furrtek/VirtualTap/JTAG_pinout.png

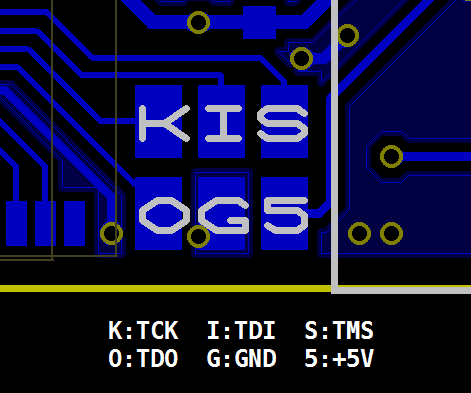
JTAG_pinout.png
