furrtek/VirtualTap/pcb/vt_c_schematic.png

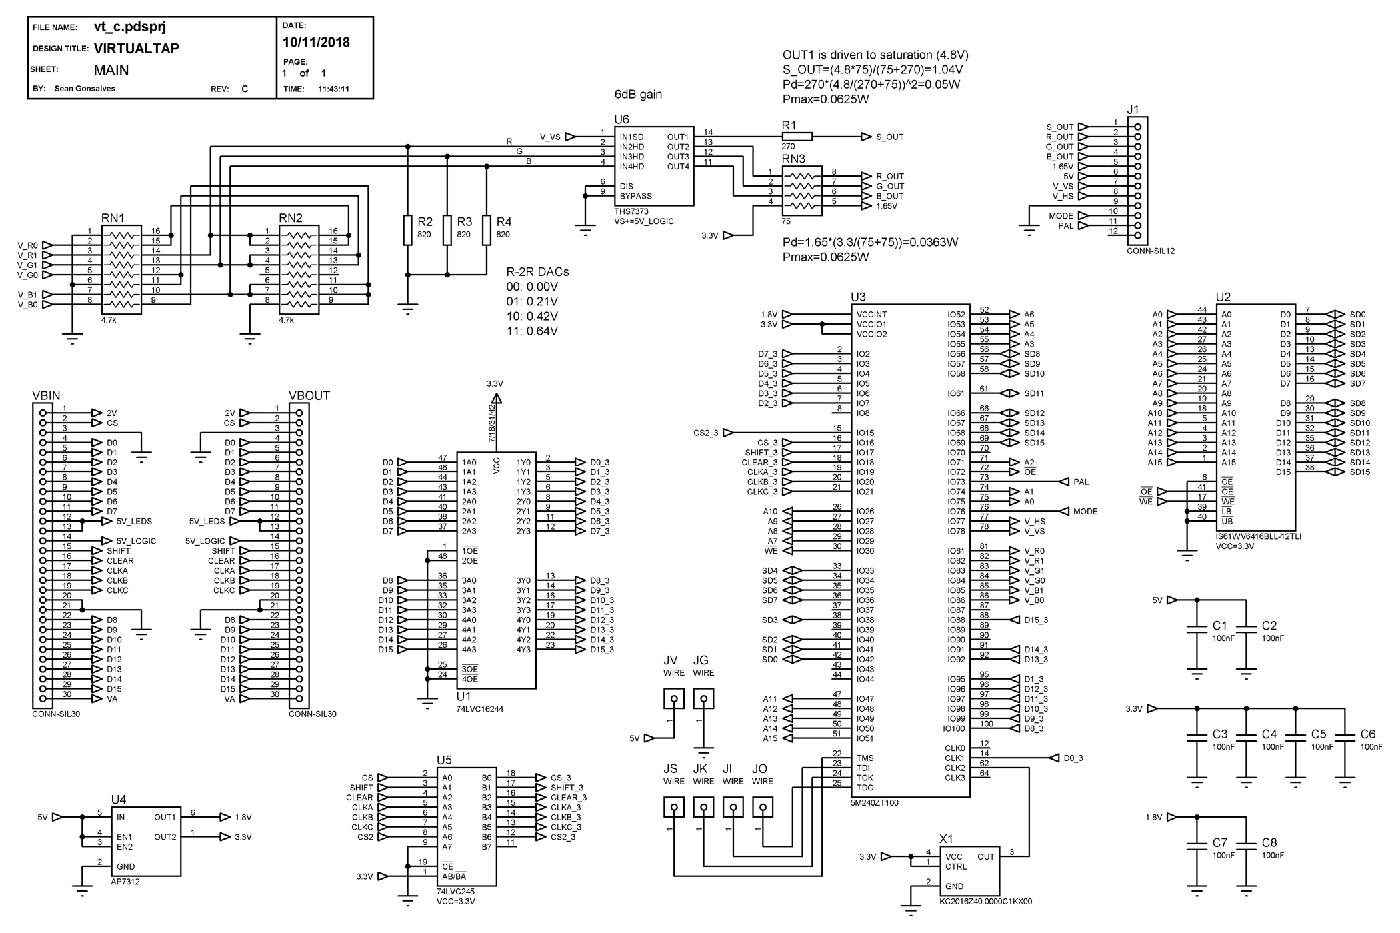
pcb/vt_c_schematic.png
