furrtek/VirtualTap/servo_emu/firmware/tl866_programmer/Screenshot 2022-01-21 at 16.46.50.png

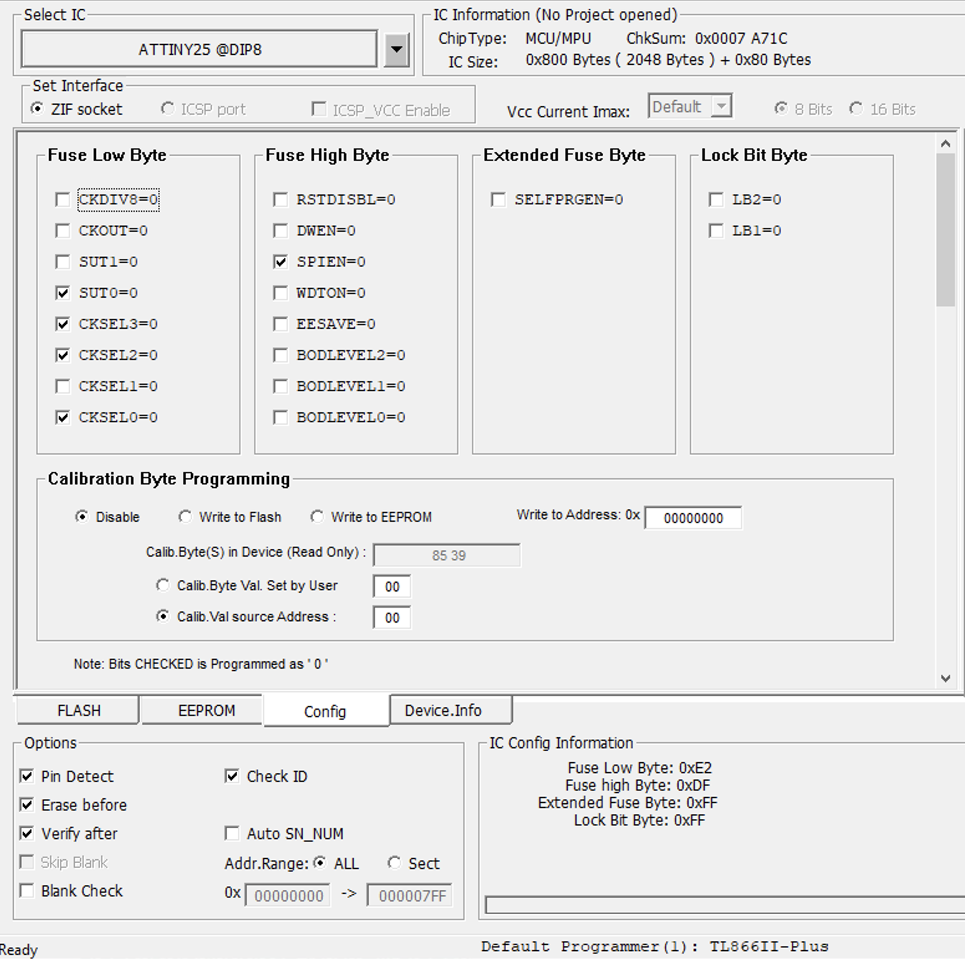
servo_emu/firmware/tl866_programmer/Screenshot 2022-01-21 at 16.46.50.png
