furrtek/VirtualTap/(list of files, drawings)

Other design files:
pcb/vt_c.pdsprj
