furrtek/VirtualTap/doc/manual_servo_emu_v1_en_anon.pdf

It simulates the presence of the original servo board and mirrors assembly, to allow the main board to run without them.

# what it does

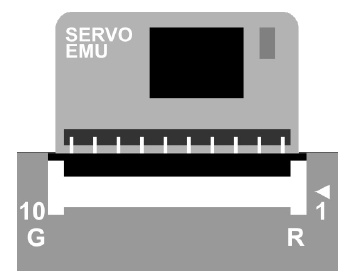
[picture p9: figure]

Installation is very simple, no soldering is required:
- Locate the servo board connector on the Virtual Boy main board. It's on the opposite edge of the cartridge connector and has 10 contacts.
- Gently slide the black part outwards to release the wires.
- Remove the protective foam from the servo emulator pins.
- Make sure each pin is straight and insert them in the connector, white inscriptions on the board facing up.
- Slide the black connector part back in to secure the servo emulator.

# servo emulator

Installation manual v1

# installation
