furrtek/VirtualTap/servo_emu/pcb/wiring.png

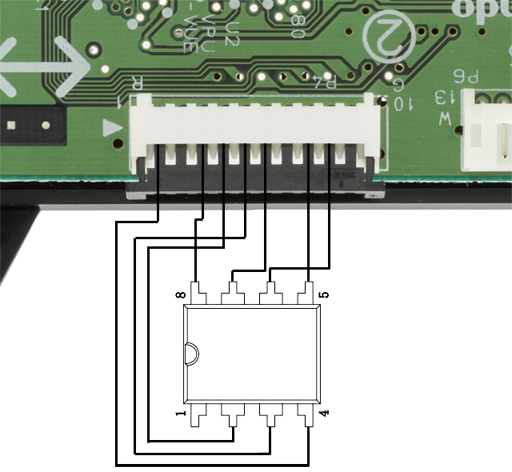
servo_emu/pcb/wiring.png
