furrtek/VirtualTap/tester/pcb/vt_tester_schematic.png

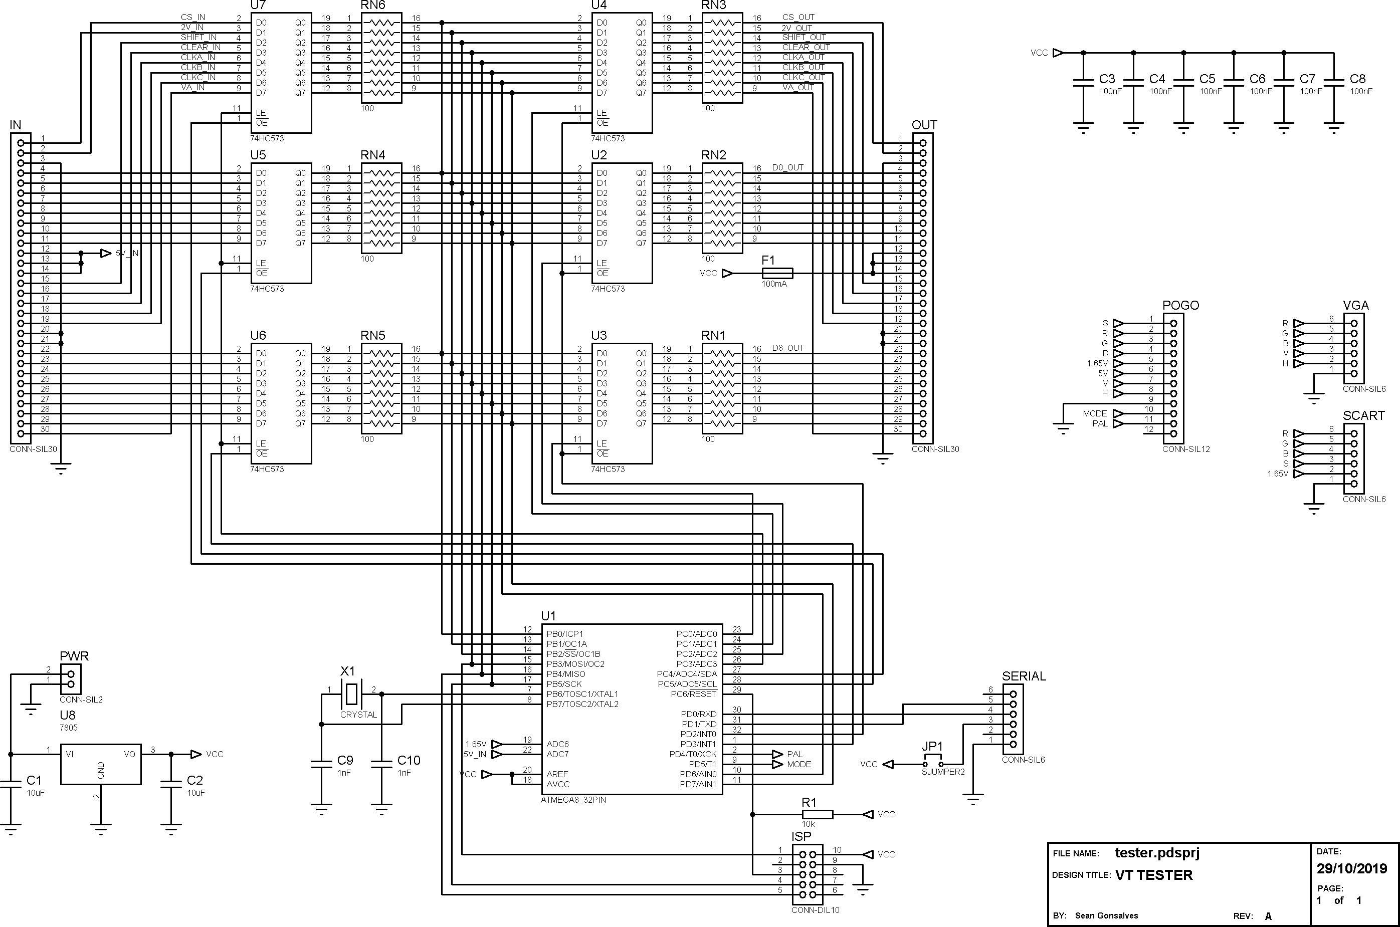
tester/pcb/vt_tester_schematic.png
