furrtek/VirtualTap/(threads)

Thread 1 (2021-03-28):

Servo Parts

Icelvlan88, 2021-03-28:
Hello,

Is there a parts list for servo?

furrtek, 2021-03-28:
Hello,

- U1: ATTiny25 in DIP8 package
- C1: 100nF 1206 MLCC
- Connector: right-angle 10-pin 2mm pitch header

Icelvlan88, 2021-03-28:
Thanks!

Closed 2021-03-28.

Thread 3 (2022-01-21):

Hex not working - solution found

itslemcy, 2022-01-21:
Hi @furrtek  , the hex file does not work if flashed via a tl866 or an arduino, so i recompiled it and created another one that works. This new files has been flashed multiple times on an attiny25 via the tl866ii plus without any issues. Check out my fork if you find it useful.

furrtek, 2022-01-30:
Hello, thanks for letting me know :)
Can you submit a pull request ?

Thread 4 (2022-01-29):

Capacitor C1-C8

Icelvlan88, 2022-01-29:
Hello,

Capacitors,8,C1-C8,100nF,0603 100nF MLCC,CGB3B3X5R1E474K055AB

This is showing 100nf, but the SKU is 0.47uf.

Assume it should be 100nf instead from what I saw in the schematic?

Do you have a SKU you'd recommend?

furrtek, 2022-01-30:
Hi, thanks for reporting this mistake.
The capacitors are 100nF, you can go with any X5R or similar spec, as long as they're rated for more than 5V and 0603 in size.

Icelvlan88, 2022-01-31:
Perfect I found similar ones to the one with had. Going to us 25V

Thread 7 (2023-01-09):

U8 on Tester board

djeepmyers, 2023-01-09:
On the schematic U8 of the Tester PCB appears to be the part with Vi, Vo, and GRD. I am not sure what the component is? Is it a voltage converter? Sorry I only have some experience with PCBs and making them. Thank you for all your work!

Closed 2023-01-09.

Thread 8 (2025-02-27):

BOM - Outdated Component

PJSOConnell, 2025-02-27:
Hi all -

A BOM item seem to be outdated.

CAT16-472J8LF is no longer available.

What would be a good substitute?

Thanks!

furrtek, 2025-02-27:
Hi. It's a simple resistor array, anything fitting the same specs (8x 4.7k isolated in 2406 package) would do.

PJSOConnell, 2025-03-19:
> Hi. It's a simple resistor array, anything fitting the same specs (8x 4.7k isolated in 2406 package) would do.

Thank you again, closing as not an issue.

Closed 2025-03-19.
