furrtek/VirtualTap/tester/firmware/io.h

#define DATA_MASK_PB	0b00111111
#define DATA_MASK_PD	0b11000000

#define LE_HIGH	PC0
#define LE_CTRL	PC1
#define LE_LOW	PC2
#define LE_IN	PC3
#define OE_LOW	PC4
#define OE_CTRL	PC5

#define OE_OUT	PD2
#define OE_HIGH	PD3
#define PAL		PD4
#define MODE	PD5
#define D6		PD6
#define D7		PD7

// ADC6: 1.65V in
// ADC7: 5V in
