furrtek/VirtualTap/(commit log)

2018-09-02 Servo emu code
2018-09-03 Simplified servo emu serial send
2018-11-10 Let it go, let it gooooo ♩
    [assignments.csv, vt_c.pdsprj, vt_c_BOM.csv]
2018-11-30 Added wiring diagram
2018-12-16 Simplified and speed fixed servo emu code
    [servo_emu.c]
2019-05-05 Added fuse values
2019-05-05 Added servo emu manual
2019-10-30 Added testing rig GERBER, schematic and firmware Added servo emu GERBER
